sui001/polyp/firmware/polyp_3x3_dither_v3_4/polyp_3x3_dither_v3_4.ino

/*
 * PROJECT: Polyp (notwled servo console)
 * DEVICE:  3x3 rig, dither test, ESP32-S3 SuperMini
 *
 * v3.4, on v3.0's native LEDC driver.
 *
 * WHAT DITHER IS AND WHY IT MIGHT WORK HERE. A cheap analog servo ignores
 * commanded changes smaller than its deadband (typically 5-10us), so during
 * slow motion the command creeps below that threshold, nothing happens for
 * several updates, then error accumulates past it and the servo catches up
 * in one visible jump. That is the residual texture left after v2.0/v3.0
 * fixed the firmware faults.
 *
 * Dither is the standard control-systems answer to exactly this, used on
 * valves and hydraulics against stiction: superimpose a small, fast noise
 * on the command so individual updates keep crossing the threshold in both
 * directions. The actuator's own inertia low-passes the noise away (these
 * servos plus a 250mm arm respond at maybe 5-10Hz, the dither runs at 50Hz),
 * while the AVERAGE position still tracks the smooth underlying command. So
 * the servo keeps moving in small real increments instead of stalling and
 * lurching.
 *
 * The idea came from a pot-driven sketch: an analog potentiometer's own
 * electrical noise dithers the command constantly, which is part of why
 * knob-driven servos often feel smoother than programmatically driven ones.
 *
 * COSTS, WHICH MATTER FOR A GALLERY PIECE. Dither means the servos are
 * never allowed to settle. Expect some audible buzz, more current draw, and
 * more gear wear over a long run. If it sounds bad or only marginally helps,
 * it is not worth it for a piece meant to run for hours. Judge with ears as
 * well as eyes.
 *
 * TEST STRUCTURE: cycles OFF -> 2us -> 5us -> 10us, 15s each, announced over
 * serial. Noise is drawn independently per servo, so they don't buzz in
 * unison (which would be both louder and less effective).
 *
 * Frame rate is fixed at 50Hz here. The 50/100Hz A/B in v3.3 showed no
 * visible difference, which means resolution is no longer the binding
 * constraint, so this changes one variable only.
 *
 * WIRING: GPIO 1,3,4,5,6,7,8,10 -> servo 1..8. GPIO 2,9,11 unused.
 */

#define VERSION "3.4"

// ---------------- CONFIG ----------------

const int SERVO_COUNT = 8;
const int SERVO_PINS[SERVO_COUNT] = {1, 3, 4, 5, 6, 7, 8, 10};

const float SHAFT_TO_TIP_MM = 250.0;

const int SERVO_HZ = 50;   // fixed; 100Hz showed no visible benefit
const int RES_BITS = 14;
const int MIN_US   = 500;
const int MAX_US   = 2400;

// the A/B: dither amplitude in microseconds, +/- that much, cycled
const float DITHER_US[] = {0.0, 2.0, 5.0, 10.0};
const int   DITHER_COUNT = sizeof(DITHER_US) / sizeof(DITHER_US[0]);
const unsigned long PHASE_MS = 15000;

const float OSC_LOW_DEG  = 60.0;
const float OSC_HIGH_DEG = 120.0;

const int   GROUP_COUNT = 3;
const float GROUP_PERIOD_S[GROUP_COUNT] = {12.0, 5.0, 2.0};
const char *GROUP_NAME[GROUP_COUNT] = {"slow", "mid", "fast"};

// servos 2,5,8 sit one spline tooth (14.4 deg) high, see v3.2
float angleTrim[SERVO_COUNT] = {0.0, -15.0, 0.0, 0.0, -15.0, 0.0, 0.0, -15.0};

const float LOWER_DEG = 0.0;
const unsigned long LOWER_HOLD_MS = 2000;
const float RAISE_TO_DEG  = 75.0;
const float RISE_STEP_DEG = 1.0;
const int   RISE_STEP_MS  = 15;
const int   PAUSE_BETWEEN_SERVOS_MS = 200;

// -----------------------------------------

bool attachedOk[SERVO_COUNT];
const uint32_t TICKS = 1UL << RES_BITS;

float ditherUs = 0.0;
int phaseIdx = 0;

int groupOf(int i) { return i % GROUP_COUNT; }

uint32_t usToDuty(float us) {
  return (uint32_t)lroundf(us * (float)TICKS / (1000000.0f / SERVO_HZ));
}

float degToUs(float deg) {
  if (deg < 0) deg = 0;
  if (deg > 180) deg = 180;
  return MIN_US + (deg / 180.0f) * (MAX_US - MIN_US);
}

// each servo gets its own draw, so they don't all buzz in step
float ditherSample() {
  if (ditherUs <= 0.0f) return 0.0f;
  return ((float)random(-1000, 1001) / 1000.0f) * ditherUs;
}

void writeDeg(int i, float deg) {
  if (!attachedOk[i]) return;
  float us = degToUs(deg + angleTrim[i]) + ditherSample();
  if (us < MIN_US) us = MIN_US;
  if (us > MAX_US) us = MAX_US;
  ledcWrite(SERVO_PINS[i], usToDuty(us));
}

void announcePhase() {
  float usPerTick = (1000000.0f / SERVO_HZ) / (float)TICKS;
  if (ditherUs <= 0.0f) {
    Serial.println("DITHER off (baseline)");
  } else {
    Serial.printf("DITHER +/-%.1f us  (= %.1f LEDC steps, %.3f mm at tip)\n",
                  ditherUs, ditherUs / usPerTick,
                  SHAFT_TO_TIP_MM *
                    sinf(radians(ditherUs / ((float)(MAX_US - MIN_US) / 180.0f))));
  }
}

void setup() {
  Serial.begin(115200);
  delay(3000);
  Serial.printf("\nPolyp 3x3 dither test, firmware v%s\n", VERSION);
  randomSeed(esp_random());

  for (int i = 0; i < SERVO_COUNT; i++) {
    attachedOk[i] = ledcAttach(SERVO_PINS[i], SERVO_HZ, RES_BITS);
  }
  for (int i = 0; i < SERVO_COUNT; i++) writeDeg(i, LOWER_DEG);

  Serial.print("attached:");
  for (int i = 0; i < SERVO_COUNT; i++) {
    Serial.printf(" s%d/GPIO%d=%s", i + 1, SERVO_PINS[i],
                  attachedOk[i] ? "OK" : "FAIL");
  }
  Serial.println();

  Serial.printf("LOWER: all to %.0f deg, holding %lums\n", LOWER_DEG, LOWER_HOLD_MS);
  delay(LOWER_HOLD_MS);

  Serial.println("RAISE: one at a time, in order.");
  for (int i = 0; i < SERVO_COUNT; i++) {
    Serial.printf("  >> servo%d GPIO%d (%s)\n", i + 1, SERVO_PINS[i],
                  GROUP_NAME[groupOf(i)]);
    Serial.flush();
    for (float d = LOWER_DEG; d <= RAISE_TO_DEG; d += RISE_STEP_DEG) {
      writeDeg(i, d);
      delay(RISE_STEP_MS);
    }
    writeDeg(i, RAISE_TO_DEG);
    delay(PAUSE_BETWEEN_SERVOS_MS);
  }

  Serial.printf("SWAY: cycling dither every %lus. Listen as well as look, "
                "buzz and heat are the cost.\n", PHASE_MS / 1000);
  announcePhase();
}

void loop() {
  const float mid = (OSC_LOW_DEG + OSC_HIGH_DEG) / 2.0;
  const float amp = (OSC_HIGH_DEG - OSC_LOW_DEG) / 2.0;

  static unsigned long lastPhase = 0;
  if (millis() - lastPhase > PHASE_MS) {
    lastPhase = millis();
    phaseIdx = (phaseIdx + 1) % DITHER_COUNT;
    ditherUs = DITHER_US[phaseIdx];
    announcePhase();
  }

  float t = millis() / 1000.0;

  float groupAngle[GROUP_COUNT];
  for (int g = 0; g < GROUP_COUNT; g++) {
    groupAngle[g] = mid + amp * sinf((2.0f * PI / GROUP_PERIOD_S[g]) * t);
  }
  for (int i = 0; i < SERVO_COUNT; i++) {
    writeDeg(i, groupAngle[groupOf(i)]);
  }

  delay(1000 / SERVO_HZ);
}
