sui001/polyp/(commit log)

2026-09-06 Init polyp repo, add patch-layout + effects console
    Notwled for servos: arrange PCA9685 patches into a shared grid, run
    effects (ripple/sweep/chase) across the stitched space same as WLED's
    2D panel setup does for LED matrices.
2026-09-06 v0.2.0: light theme, servo/panel inspector, groups, orbit re-pivot
    - Off-white theme (cool sage-grey, not cream) replaces the dark console.
    - Click a servo for a type dropdown (SG90/MG90S/DS3218MG/FS90R) plus
    stick length/thickness/orientation. Body scales with the selected type.
    - Click a panel for x/y/z position, orientation, and size, shift-click to
    multi-select and group/ungroup, grouped panels drag together.
    - Double-click the scene to re-center the orbit pivot, was previously
    stuck on the origin.
    - Added VERSION file, bumping it each iteration from here.
2026-09-06 v0.3.0: body stays put, output sweeps like a wiper
    Was rotating the whole servo (body + horn) as one rigid pivot, backwards
    from a real servo where the case is bolted down and only the output
    shaft moves. Split into a fixed mount (pivot, holds the body) and a
    separate wiperPivot held slightly off the body's face that sweeps on
    its own axis, the horn now floats and sweeps while the case is still.
    Also default to a single isolated 1x1 servo (new preset) instead of a
    9-patch grid, easier to judge the motion on its own before scaling back up.
2026-09-06 v0.4.0: real-world scale, world unit = 1cm
    Body, horn, cell pitch, board gap, camera framing all rebuilt off real
    SG90-class 9g servo dimensions (22.8x12.2x28.5mm body, 4.8mm shaft) instead
    of arbitrary made-up numbers. Horn is now a flat box like a real servo
    arm, not a round rod. Inspector sliders show cm instead of raw units.
2026-09-06 v0.5.0: remove fog, mount rotation, 1m horn
    - Fog distances were tuned pre-rescale, at real cm units and 60cm zoom it
    fogged out almost everything. Removed fog entirely, swapped the rendered
    backdrop plane for an invisible raycast-only one so double-click-to-recenter
    still works without a visible wall of bgColor.
    - New "mount" tilt/pan sliders rotate the whole servo (case + shaft + horn),
    the existing "stick orientation" slider only spun the horn in its own plane
    and couldn't point it anywhere else.
    - Horn length slider now goes to 100cm.
2026-09-06 v0.6.0: lock a servo's settings in as the default for all
    New "Match" section in the servo inspector: tune one servo (type, stick
    length/thickness/orientation, mount tilt/pan), hit lock in, and it copies
    onto every other servo currently in the rig. Also becomes the template
    for any servo or patch added afterward, so growing the rig stays consistent
    instead of reverting to the SG90 default each time.
2026-09-06 v0.7.0: wall/floor/roof aspect, fix panel spacing
    - New Aspect control (wall/floor/roof) rotates the whole rig: wall is the
    existing vertical view, floor lays it flat shafts-up, roof flips it
    shafts-down like a Tuft ceiling mount. Dragging and the ripple-click
    now compute against the rig's own rotated plane instead of a fixed
    world-space one, so arranging still works in every aspect.
    - Fixed panel spacing: the old "board gap" slider only affected where
    brand-new patches got placed, moving it did nothing to patches already
    on the grid. It now rescales every existing patch's position too.
    Relabeled the control "panel spacing" to match.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
2026-09-06 v0.8.0: reset rig, servo spacing, motion controls, dials back to sliders
    - "reset rig" button next to "reset view": restores layout, spacing,
    servo template, aspect, camera and mode to factory defaults in one
    click, for when arranging goes sideways.
    - New "servo spacing" slider (cell pitch on a panel), distinct from
    "panel spacing" (gap between boards) which was the only one before.
    - New "Motion" section: speed now drives both idle sway and run-mode
    effects (previously arrange-mode motion ignored the speed slider
    entirely), and a new swing range slider replaces the hardcoded
    +/-49 degree sweep amplitude.
    - Patches and cells/patch dials replaced with sliders, matches every
    othe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
2026-09-06 v0.9.0: wind/dominoes effects, per-servo pan, length profiles, export
    - Every servo is now a servo mounted on a servo: a new pan stage carries
    the whole top servo (case, shaft, horn) in yaw, so directional effects
    can point a stalk somewhere instead of only bending it in one plane.
    - Two new effects: wind (constant directional lean, gusts only ever add
    to it, tips ripple but never blow back past the lean) and dominoes (a
    directional cascade that snaps each stalk over, holds, then recovers).
    Sweep and chase now share a "direction" slider instead of fixed axes.
    - Per-panel horn length profiles: uniform / stepped / peaked / concave,
    each board tapers from its own centre outward.
    - G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
2026-09-08 Add firmware for the physical 3x3 FS90R rig
    Direct-GPIO ESP32-S3 SuperMini sketch, no PCA9685 (this rig doesn't have
    one). Reproduces the console's ripple effect, reinterpreted for
    continuous-rotation servos: FS90R has no absolute angle, so the wave
    drives speed around each unit's calibrated stop point instead of tilt.
    Position-only export fields (type, stick geometry, mount angles) don't
    apply to this hardware and are dropped.
    [polyp_3x3_fs90r_v1_0.ino]
2026-09-08 Move firmware into a proper Arduino sketch folder
    arduino-cli (and the Arduino IDE) require the .ino's parent folder to
    share its name, flat files don't compile. Restructured so this can be
    recompiled and reflashed, not just read.
2026-09-09 Add SG92R positional firmware, flashed to the rig
    Servos swapped from FS90R (continuous) to SG92R (positional), same pins
    and layout. This version applies the ripple wave directly as a bend
    angle around 90 degrees rather than the speed-command workaround the
    FS90R version needed, closer to what the console actually models.
    Compiled and uploaded to COM42.
    [polyp_3x3_sg92r_v1_0.ino]
2026-09-09 Add gentle synchronized sway test, flashed to the rig
    Stand all 9 to 90 degrees, hold, then sway together (no per-servo phase,
    no ripple across the grid) at an angle worked out from a physical ask:
    horn is 25cm shaft-to-tip, sway the tip about 5cm either side, so
    swingDeg = asin(5/25) computed in setup() rather than hardcoded. Also
    adds the servo-attach diagnostic sketch used to confirm servo8/GPIO9 is
    a dead servo, not a wiring or firmware fault.
2026-09-09 v1.1 sway: fix stair-step jerkiness, write microseconds not degrees
    v1.0 rounded the target to a whole integer degree before calling
    Servo::write(), across a +/-11.5 degree sway at 50Hz that's a visible
    staircase, not a curve. Keep the angle as a float throughout and write
    microseconds directly instead, about 10x finer resolution than
    whole-degree steps. Flashed to the rig.
    [polyp_3x3_sway_v1_1.ino]
2026-09-09 v1.2 sway: remap servo8/9 off suspect GPIO9
    GPIO9 (servo8) confirmed dead, wiring tested good, diagnostic sketch
    showed all other attaches fine. Retired it rather than trust it:
    servo8 GPIO9->GPIO10, servo9 GPIO10->GPIO11. GPIO11 is in the SuperMini's
    confirmed-usable pool, just unused until now. Motion code unchanged from
    v1.1, this is a pin remap only. Flashed to the rig, physical rewire
    (move servo8's signal wire to GPIO10, servo9's to GPIO11) still needed
    to match.
2026-09-09 v1.3 sway: fewer, bigger, more confident steps instead of a continuous creep
    Different theory of the jerk than v1.1's. Bench testing found the servos
    move perfectly smoothly on the fast stand-up-to-90 move, only chattering
    on the slow sway, classic analog-servo behaviour: confident moves with
    real position error execute cleanly, tiny continuous corrections dither.
    v1.1 went the wrong direction (finer resolution, still streamed every
    20ms). This samples the same sine trajectory only every 350ms and sends
    one full-sized target each time, letting the servo do the kind of move
    it's already proven to do smoothly. Trades continuous glide for distinct
    steps, worth comparing by feel against v1.1/v1.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
    [polyp_3x3_sway_v1_3.ino]
2026-09-09 v1.4 sway: triangle wave, back to continuous 50Hz updates
    Third theory of the jerk. v1.1 (sine, 50Hz) chattered because it
    lingers near-zero velocity at each extreme, dwelling near-static with
    tiny residual error, exactly the condition that lets an analog servo's
    loop dither. v1.3 (sine, stepped every 350ms) fixed the chatter but
    looked like distinct steps instead of motion. This keeps v1.1's
    continuous streaming (so it can look fluid) but swaps sine for a
    triangle wave: constant velocity the whole traverse, instant reversal
    at the ends, never lingering. Flashed to the rig.
    [polyp_3x3_sway_v1_4.ino]
2026-09-09 v2.0: fix the actual causes, 10-bit PWM and 8-channel exhaustion
    Both faults were in this firmware. v1.1-v1.4 chased the wrong thing and
    blamed the servos; Sui was right that it wasn't hardware.
    Jerk: ESP32Servo defaults to a 10-bit LEDC timer, splitting the 20ms
    frame into 1024 ticks = 19.5us = 1.85 deg = an 8.1mm jump at the tip of
    a 250mm horn. A 50mm sway therefore had ~12 reachable positions, which
    is the "10-11 jabs" that was counted. Every prior version computed
    sub-degree floats and handed them to a peripheral that rounded to the
    nearest 8mm. Fixed with setTimerWidth(14), the S3's hardware maximum:
    now 1.22us / 0.116 deg / 0.505mm per step, verified on device at boot.
    Note setTimerW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
    [polyp_3x3_sway_v2_0.ino]
2026-09-09 v2.1: staged reset/raise/sway startup, wider 75-105 sway
    Three stages: all to 0 and hold, then raise servo 1..8 one at a time so
    each can be watched individually (doubles as a liveness check, since only
    6 of 8 were observed moving), then continuous 75-105 sway together.
    Wider travel is deliberate. The residual jitter after v2.0 is most likely
    analog deadband (these ignore pulse changes under ~5-10us; we now step at
    1.22us) plus gear backlash amplified by a 250mm horn, ~20x the arm these
    servos are designed for. Neither is fixable in firmware, but both shrink
    as a proportion of travel when the motion is bigger.
    RISE_STEP_DEG defaults to 1.0 as asked, though that's 4.4mm at the tip,
    nearly 9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
2026-09-09 v3.0: drop ESP32Servo, drive LEDC directly
    Four faults traced to ESP32Servo across this bring-up, every one of which
    presented as "the servos are bad":
    1. DEFAULT_TIMER_WIDTH 10 -> 19.5us steps -> 8.1mm jumps at a 250mm tip
    2. attach() resets timer_width, so setting it beforehand is discarded
    3. setTimerWidth's tick rescale divides by the bit difference, not 2^diff
    4. its allocator gave servos 7 and 8 channel slots the S3 doesn't have
    (ids 110/111, outside the working 100-105 block). Both reported
    attached()==OK and emitted nothing. Confirmed on the bench: exactly
    servos 7 and 8 dead, which is the "only 6 working" that had been
    blamed on wiring and faulty units fo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
    [polyp_3x3_native_v3_0.ino, polyp_3x3_sway_v2_2.ino]
2026-09-09 v3.1: three speed groups by column
    servos 1,4,7 slow (12s), 2,5,8 mid (5s), 3,6 fast (2s), same 75-105
    amplitude throughout so only speed varies. Those groups are the columns
    of the 3x3 and fall out as index % 3, so it reads left-to-right as a
    speed gradient. Groups run free against a shared clock rather than
    phase-locked, so they drift in and out of sync.
    Doubles as a clean test of what's left after the firmware faults: same
    servos, same resolution, only speed differs, so if the fast column reads
    smoother than the slow one that's the servo deadband showing itself.
    [polyp_3x3_groups_v3_1.ino]
2026-09-09 v3.2: widen sway to 60-120, trim servos 2,5,8 by one spline tooth
    Sway widened from 75-105 to 60-120 for all groups, +/-125mm at a 250mm
    horn. Startup reset and sequential raise kept, they were working well.
    servos 2,5,8 swayed 90-120 on the bench while the rest did 75-105, 15
    degrees high. Nothing in firmware offsets a group, and a 25-tooth spline
    is 14.4 degrees per tooth, so those three horns are seated one tooth off.
    Corrected in angleTrim rather than by re-seating them.
    Also records a confirmed finding: the fast column reads visibly smoother
    than the slow one at identical amplitude and resolution, which pins the
    last of the residual texture on the servo deadband. It's bought with
    spee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
    [polyp_3x3_groups_v3_2.ino]
2026-09-09 v3.3: alternate 50Hz/100Hz to A/B frame rate and resolution
    The S3's 14-bit LEDC register can't be widened, but tick size is the frame
    divided by those 16384 steps, so a shorter frame buys finer steps:
    50Hz 1.221us = 0.116 deg = 0.505mm at a 250mm tip
    100Hz 0.610us = 0.058 deg = 0.252mm
    Alternates every 15s so the two can be compared back to back. Verified on
    device: ledcChangeFrequency switches cleanly and the resolution halves as
    predicted.
    Also answers a question that carries to the PCA9685 on order: that board
    is 12-bit (4.88us / 2.0mm at 50Hz, coarser than this rig runs now) and its
    resolution scales with frame rate the same way, so whether these SG92Rs
    tolerate 100Hz decides whet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
    [polyp_3x3_hztest_v3_3.ino]
2026-09-09 v3.4: dither test against the servo deadband
    Cycles dither amplitude off -> 2us -> 5us -> 10us every 15s, noise drawn
    independently per servo so they don't buzz in unison. Frame rate pinned
    back to 50Hz: the v3.3 A/B showed no visible difference between 50 and
    100Hz, which means resolution is no longer the binding constraint and
    this should vary one thing only.
    Rationale: an analog servo ignores commanded changes below its deadband
    (~5-10us), so slow motion stalls then lurches. Superimposing fast small
    noise keeps updates crossing that threshold in both directions while the
    arm's own inertia low-passes the noise away, so average position tracks
    smoothly. Standard technique against stiction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
    [polyp_3x3_dither_v3_4.ino]
2026-09-09 v3.5: mechanical diagnostic, stop guessing at what's left
    Not an effect, a measurement. Firmware causes are exhausted: after v2.0/
    v3.0 fixed the real ones, 50->100Hz made no visible difference and dither
    from 0 to +/-10us made no visible difference. +/-10us is 4.2mm at a 250mm
    tip and should have visibly shaken the arm if the servo tracked it. It
    didn't, which points at mechanical slop rather than signal precision.
    Three phases to separate the remaining candidates:
    1. HOLD STILL - nothing commanded to move. Twitching = servo loop hunting.
    2. BACKLASH - approach 90 deg from below, then from above. If the tip
    rests in two places, that gap is backlash and can be measured with a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
    [polyp_mech_diag_v3_5.ino]
2026-09-09 Add wiggle effect (v4.0) and assembly hold-at-90 utility
    wiggle_v4_0: everything rests at 100 deg, 1-3 random tips get a 5 deg
    shiver every 2-3s. Each is an enveloped oscillation (sine window, 2 cycles
    inside 900ms) so it starts and ends exactly at rest with no step at either
    end. Per-servo state, so shivers overlap rather than pulsing in lockstep.
    Suits this hardware better than the sway did: the servos are stationary
    most of the time, out of the slow-creep regime where they look worst.
    hold90_v1_0: parks all eight at 90 for horn fitting, re-asserted every
    second. Trim deliberately NOT applied: it would put servos 2,5,8 at a
    different true shaft angle from the rest and build the old one-to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
    [polyp_3x3_hold90_v1_0.ino, polyp_3x3_wiggle_v4_0.ino]
2026-09-09 v4.1: gentle breeze, trim zeroed after the horn change
    Rests at 100 deg and never stops moving. Where v4.0 fired discrete random
    shivers (which reads as "something startled it"), a breeze differs in
    three ways, all implemented here:
    - continuous rather than event-driven, nothing switches on or off
    - spatially correlated: phase is offset by grid position, mostly by
    column, so the motion visibly travels across the rig instead of each
    stalk twitching independently. This is what most separates breeze
    from random twitching.
    - gusty: a slow envelope swells and fades the whole field, and never
    reaches zero so it's never quite still.
    Flutter and gust are each two sines at inc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
    [polyp_3x3_breeze_v4_1.ino]
2026-09-09 v5.0: full 3x3, nine servos, past the 8-channel LEDC ceiling via MCPWM
    The S3's LEDC has 8 channels and that's hard, which is why servo9 was
    never drivable and why a "dead" servo kept wandering between pins. But
    LEDC is only the peripheral servo libraries happen to use. The S3 also
    has MCPWM: 2 groups, 6 outputs each, 12 more channels, and it's the
    peripheral actually intended for motor control.
    servos 1-8 on LEDC as before, servo9 on MCPWM/GPIO11. Breeze unchanged
    from v4.1, now covering all nine grid positions.
    LEDC 14-bit over 20ms -> 1.22us/step
    MCPWM 1MHz, 20000 ticks -> 1.00us/step, and the compare value IS the
    pulse width in us, which reads bett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
2026-09-09 v5.1: 12 servos, every broken-out pin, no soldering and no PCA9685
    8 on LEDC (its hard 8-channel limit) + 4 on MCPWM = 12, which is exactly
    the number of usable pins this board breaks out (1,3-13, GPIO2 excluded).
    GPIO9 back in service after being cleared.
    MCPWM allocation fixed properly: each operator drives 2 generators with
    their own comparators, so 6 fit in group 0 sharing one timer. v5.0 used
    one operator per servo and would have capped at 3.
    Grid is now 4 cols x 3 rows with GRID_COLS configurable, so the breeze's
    travel direction follows the physical layout.
    Chip ceiling for the record: LEDC 8 + MCPWM 12 = 20 channels. Twelve is
    what the pins allow; the rest needs the underside pads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
    [polyp_grid12_breeze_v5_1.ino]
2026-09-10 v6.0: 19 channels wired, 16 active for the 4x4, sequential pin map
    MCPWM now walks both groups (v5.1 only allocated group 0 and capped at 6):
    servo -> group n/6, operator (n%6)/2, two generators per operator. Verified
    on device, 16/16 up, so servos 15-16 on group 1 are real.
    ACTIVE_COUNT gates how many of the pin list come up, so the same firmware
    covers the 4x4 test now and the full 19 later without re-pinning.
    Pin map re-sequenced per the 2026-09-10 rewire (servo8->GPIO9,
    servo9->GPIO10). The whole thing collapses to one rule: servo1 -> GPIO1,
    then servo N -> GPIO N+1, because GPIO2 is skipped as a strapping pin and
    everything shifts by one. Servos 1-16 occupy GPIO 1 and 3-17, no gaps.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
    [polyp_grid19_breeze_v6_0.ino]
2026-09-10 Add 4x4 sequential raise test for the assembled panel
    Loops: lower all 16 together, raise servo 1..16 one at a time, hold all
    up 5s, repeat. Each servo rises alone with a pause and announces itself
    on serial as it goes, so a miswire or dead unit identifies itself by
    number and GPIO rather than needing to be hunted for.
    Uses the 2026-09-10 sequential map: servo1 -> GPIO1, then servo N ->
    GPIO N+1 (GPIO2 skipped as a strapping pin). LEDC 1,3-9 for servos 1-8,
    MCPWM 10-17 for servos 9-16 across both groups.
    [polyp_grid16_raisetest_v1_0.ino]
2026-09-10 v6.1: 20 servos, 5x4, the chip's absolute channel ceiling
    LEDC 8 + MCPWM 12 = 20. There is no 21st without an external driver.
    The 20th pin needs no extra soldering: GPIO43 was on the header all along
    (marked TX). TX/RX are only spoken for if Serial runs over UART0, and with
    USB CDC On Boot enabled Serial goes over native USB instead, so 43 and 44
    are ordinary GPIOs. 44 left spare, 48 still free for the RGB LED. Caveat
    recorded: the ROM bootloader prints briefly to GPIO43 at power-on, so
    servo 20 may twitch once on boot.
    Torque note for the new 1100mm 2mm stainless rods, which changes what's
    hard: a 1.1m rod is ~28g, so held HORIZONTAL it asks ~1.5 kg-cm, about 60%
    of an SG92R's stall. Nea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
    [polyp_grid20_breeze_v6_1.ino]
2026-09-10 Add build photos to README
    Three photos of the physical 4x4 Tuft build: the rods fanning out, the
    servo grid close-up, and the SuperMini/breadboard wiring. Rotated per
    their EXIF orientation and resized for the repo (originals were 5712x4284
    phone photos, down to ~1350x1800 for reasonable README load time).
    Also clarified the naming split in the README itself: Polyp is the
    firmware, Tuft is what Sui calls the physical install, and noted that the
    private tuft repo is a separate, earlier ceiling-arm concept, not this.
